marooncn/plantbot/README.md

# Plantbot
    This is a project developed by Gao Yibo and me.
    We aim to design and make a differential drive robot that can realize SLAM and antonomous navigation 
    with the help of ROS. We call it plantbot, hoping it can take some tasks in the plant, such as fetching 
    and routing inspection. 
## 3D mechanical image (designed by Solidworks)
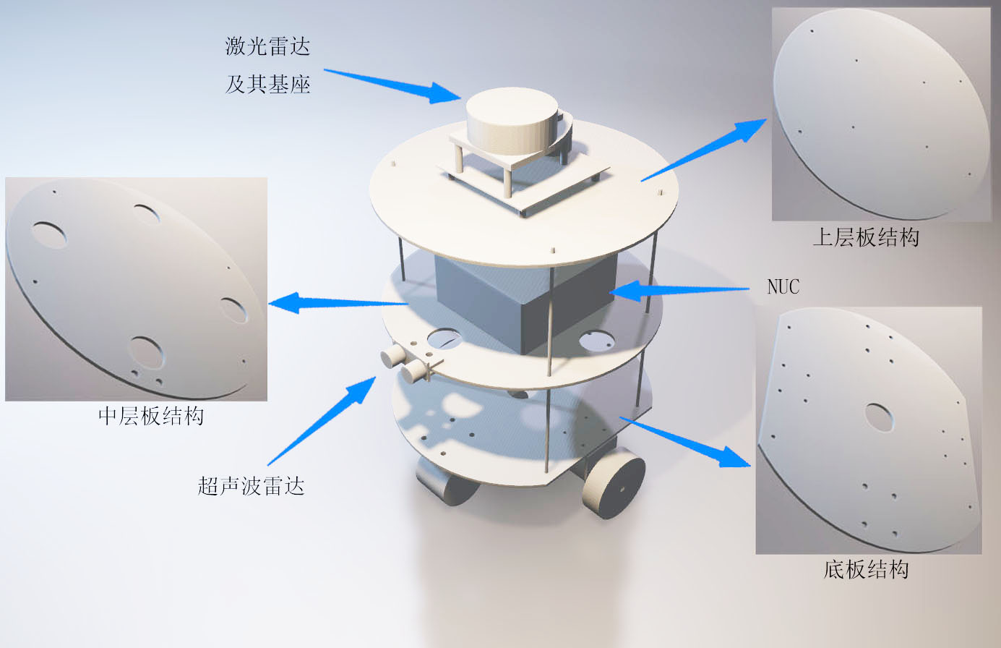
[picture p1: image/3D图.jpg]
   
## Material object
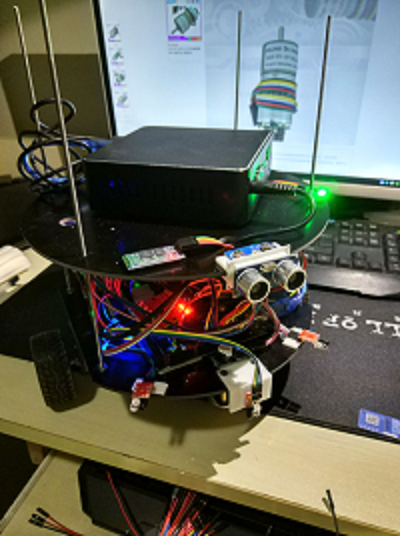
[picture p2: image/material_object.png]
   
## software flowchat
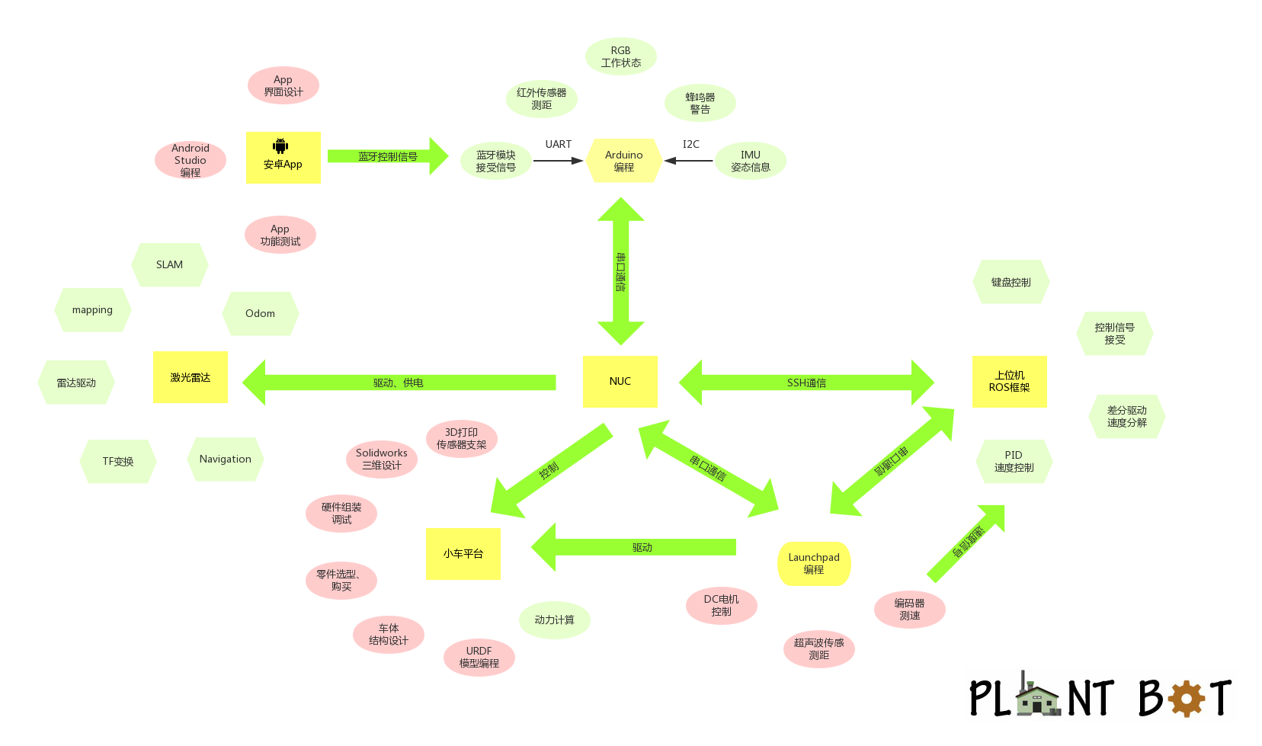
[picture p3: image/Plantbot.png]
   
## low-level control
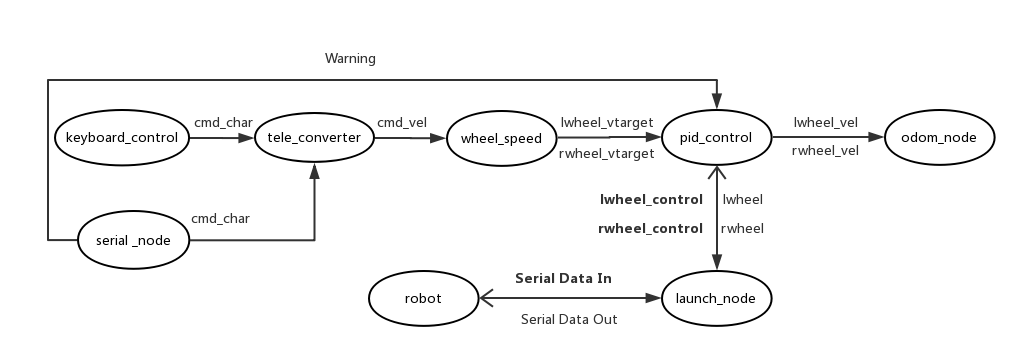
[picture p4: image/underlying_ros.png]
   
   [low-level control](https://www.processon.com/view/link/590467b6e4b027506a44d961)
## More Information 
   * thesis: <br>
   [Plantbot: A New ROS-based Robot Platform for Fast Building and Developing](https://github.com/marooncn/plantbot/blob/master/ICMA2018-164.pdf)  <br>
   Please cite this paper as:  <br>
   > Ma L, Liu Y, Gao Y, et al. Plantbot: A New ROS-based Robot Platform for Fast Building and Developing[C]//2018 IEEE International Conference on Mechatronics and Automation (ICMA). IEEE, 2018: 930-935.
   * video: <br>
   [remote control](https://pan.baidu.com/s/1Fe6rH_Bb22K6dIa3u1QXJQ)<br>
   [obstacle avoidance](https://pan.baidu.com/s/1yQQse5tHGPSfzELwWx_T1w)<br>
   [SLAM](https://pan.baidu.com/s/1IhqRWxE4FQnFmS6PtCyGzQ)
## The similar project
   https://github.com/eborghi10/my_ROS_mobile_robot
