marooncn/plantbot/rules/README.md

激光雷达、Launchpad、Arduino都是通过USB接线与NUC连接通信的，在实际开发过程中可能还会增加串口外设，这就导致了串口号的混乱，引发小车底盘ROS驱动和
串口设备的异常，使用UDEV规则文件可以指定设备串口号，从而避免串口冲突问题。串口规则文件的建立依赖于每个设备都有独立的串口ID，如激光雷达的设备ID为
“Sillcon_Labs_CP2012_USB_to_UART_Bridge_Controller_0001”。可以通过Linux终端命令查询，以此书写UDEV规则文件，
使得每次设备插入时，根据串口ID映射为固定的串口号，如ttyUSB001，同时还可以修改该串口的读写权限，这样使用串口设备再无需专门修改权限。
