marooncn/plantbot/src/rplidar_ros/launch/README.md

rplidar_ros是激光雷达rplidar的官方驱动包，可以通过下面命令下载编译rplidar的驱动：<br> 
cd ~/plantbot/src <br> 
git clone https://github.com/robopeak/rplidar_ros.git <br> 
在rplidar_ros/launch下新建hector_rplidar.launch、geotiff_mapper.launch后编译
