marooncn/plantbot/(commit log)

2017-06-21 urdf.rviz是打开rviz加载urdf模型时保存的设置文件，为自动生成
2017-06-23 Update and rename 小车控制.txt to control_command.txt
